seaweedbazaar/halloween-scooby-doo/scooby-booth-main/prompts/base.md

Image 1 is the art style reference. Image 2 is the lettering reference. Image 3 is a photo of a real person, who is the star of this comic: "the hero".

HERO DESCRIPTION (from Image 3 — follow exactly in every panel):
{{HERO_DESCRIPTION}}

{{RETRY_NOTES}}

Create a 4-panel comic strip that looks like a photographed page from a real 1970s Gold Key Scooby-Doo comic book printed on cheap newsprint. Match Image 1's art style and Image 2's lettering exactly. Use them for style only; do not copy their panels or text.

PRINT TEXTURE (most important for the look; match Image 1):
- Colors are printed with visible Ben-Day halftone dots, especially on skin, pink, yellow and blue areas. Not smooth solid fills. Halftone dots on skin keep the skin exactly as light or dark as in Image 3.
- Slight color misregistration: color fills shifted a little off the black linework, leaving small white gaps along edges and color spilling past outlines.
- Inside the panels: a slightly yellowed newsprint look with faint grain, slight ink bleed, and a soft, slightly blurry scanned-page feel. The yellowing never applies to anyone's skin.
- Limited flat 4-color print palette: hot pink, lemon yellow, sky blue, grass green, orange, purple, brown, black. No smooth gradients, no airbrushed or soft shading, no modern cel shading.
- Glowing ghosts, eyes and lights are fine, but keep them in the same flat print colors with halftone dots.
- It must look like a genuine old printed comic, not a modern digital illustration made to look retro.

LINEWORK:
- Hand-inked with a brush: thick-to-thin varying line weight, slightly uneven and wobbly, not uniform digital lines.
- Shadows done with scratchy black hatching and feathering lines, especially in hair, fur and clothing folds, not with shaded color tones.
- Only hair that is actually black or very dark is filled with solid black ink, with a few flat blue or white highlight shapes. Every character keeps their own hair color (blonde, red, brown, gray, etc.); never change anyone's hair color to black.
- Simple 1970s comic proportions like Image 1: realistic adult bodies about 7 heads tall with SMALL heads, simple inked faces, small eyes with NO shine highlights, expressions shown through eyebrows and body language. NOT a Bitmoji, NOT an avatar, NOT a modern webcomic, NOT a caricature app. No big round eyes, no glossy highlights, no smooth vector lines.

LETTERING (must look hand-lettered in a real 1970s comic book; copy Image 2 exactly):
- Hand-lettered with a pen by a comic letterer, not a computer font. Every letter is drawn by hand, so repeated letters are never identical: slight differences in size, slant and stroke thickness.
- SMALL, DENSE TEXT like Image 2: ALL CAPS letters that are small relative to the panel (roughly the height of a character's eye), narrow and condensed (each letter about half as wide as it is tall), packed tightly together with almost no space between letters, normal single spaces between words, and tight line spacing (lines nearly touching). The text forms a compact, dense block.
- The bubble hugs the text block snugly, with only a thin margin of white around it. Never a big bubble with large, airy, widely spaced letters.
- Pen strokes go thick and thin, with slightly rough, soft ink edges that spread a little into the newsprint.
- The crossbar "I" (with little bars at the top and bottom) is used ONLY for the word "I" and in "I'M" or "I'VE". All other I's are a plain single stroke.
- Emphasized words are bolder, heavier and slightly slanted.
- Ellipses are drawn as three well-spaced dots.
- Each line of text is centered in the bubble.
- Speech bubbles are hand-drawn ovals with thin, slightly wobbly black outlines, shaped snugly around the text, with a short, thin, pointed wedge tail.
- AVOID: digital comic fonts, Comic Sans, perfectly even letters, wide letter spacing, thick uniform bubble outlines, rounded-rectangle bubbles.

SOUND EFFECTS (NEVER in bubbles):
- Hand-drawn display letters, like "AAARRRGGH!" in Image 1: letters grow or shrink and tilt along the word, slightly overlapping, with a bouncy, irregular rhythm.
- Filled with a flat print color (hot pink, yellow or orange), outlined with a thick dark outline, and printed with the same halftone dots as the art.
- Placed in the background art behind the characters.

LIKENESS (equally important — these rules decide WHAT the hero looks like; the style rules above decide HOW everything is drawn and printed, including the hero):
- The hero IS the main person in the center of Image 3 (ignore anyone else partly visible at the edges of the photo) and matches the HERO DESCRIPTION exactly. Never invent a different person. Never change their skin tone, ethnicity or age.
- Draw their face and build exactly as they look in Image 3. Do not make them look more masculine or more feminine than they do in the photo, and do not push them toward a stereotypical man or woman.
- The hero is their own person, NOT a member of the Scooby-Doo gang. Never ADD anything from Shaggy's, Fred's, Velma's or Daphne's look that the person doesn't have (for example a goatee, bell-bottoms, an ascot, an orange sweater). If their own hair or features happen to resemble a gang member, draw their own exactly as in Image 3.
- HERO OUTFIT: on top, exactly the clothing visible in Image 3. From the waist down, exactly the "Lower half" given in the HERO DESCRIPTION. The full outfit is identical in every panel.
- The hero's outfit must never resemble any gang member's, and must look clearly different from the gang member they are standing next to. The hero NEVER wears: a skirt or dress (unless shown in Image 3), knee socks, Mary Jane shoes, bell-bottoms, an ascot, a neck scarf, a turtleneck, a headband, Velma's orange sweater or red skirt, Daphne's purple dress, pink tights or green scarf, Fred's white shirt and ascot, or Shaggy's green V-neck and brown pants.
- Hair: exactly as described and as in Image 3, in every panel. Never shorten it, tie it up, pull it back or hide it unless it is worn that way in Image 3. If long hair is pushed back, slicked back or tied, still show its real length (strands falling behind or over the shoulders) and texture; never turn it into short or rounded hair. Keep the exact hair color and lightness, including any gray: light blonde stays pale blonde, never darkened to golden-brown or brown.
- Facial hair: exactly as described. If the person has no facial hair, the hero's chin, jaw and upper lip are completely clean-shaven in EVERY panel: no stubble, no goatee, no chin whiskers.
- Face shape: copy the face shape from Image 3 (round stays round, soft stays soft). Never give the hero a long, narrow face, a prominent chin or droopy eyes they don't have.
- Skin tone: exactly as light or dark as in Image 3. In-between tones stay in-between; never round light or olive skin to tan or brown. One flat skin color, identical in every panel.
- Lighting: colored lights only tint the background and the floor. They never change the color of anyone's skin, hair or clothes.
- Facial features: keep their eye shape, eyelids, nose shape, lips, face shape, jawline and cheekbones exactly as in Image 3.
- Glasses, facial hair, piercings, earrings, jewelry, hats and clothing: exactly as described and as in Image 3, including logos. Do not invent new clothes unless the story says so.
The hero is drawn in the 1970s comic style, but their face may have slightly more detail than the other characters, enough to keep these features accurate.

PANELS: {{LAYOUT}} ALL FOUR panels are fully enclosed by the same thick black hand-ruled border, separated by gutters. Everything outside the panels (the page margins around the edge and the gutters between panels) is clean, flat, pure white #FFFFFF: no yellowing, no paper texture, no grain, no halftone dots, no stains. No borderless or full-bleed panels; no art extends outside its border.

HEADCOUNT (check every panel before drawing it): count the characters the story names for that panel and draw exactly that many people, no more. Show movement only with speed lines and motion marks, never by drawing a character more than once. Every character, including each Scooby-Doo gang member, appears at most ONCE per panel. Never fill extra space with a copy of a character; use background scenery instead.

THE HERO: the person from Image 3, following the HERO DESCRIPTION and LIKENESS rules. Same look in every panel. Appears ONLY ONCE per panel. Whenever the hero is next to another human character, draw them at the same scale and the same distance from the viewer; neither towers over the other.

{{STORY}}

GLOBAL TEXT RULES: Spell all text exactly as written in quotes. No other words anywhere: NO caption boxes, no narration, no time stamps, no signs, no banners, no labels, no titles, no signatures. Logos or text on the hero's own clothing from Image 3 may stay. Nothing flies through the air unless the story says so; no floating heads or extra faces.

FINAL CHECK: The hero is clearly the same person as in Image 3 in all four panels: same skin tone (never darkened by lighting or the paper effect), ethnicity, age, facial features, hair, glasses, facial hair, piercings and clothing. All four panels have black borders. Each character appears once per panel with one head. It looks like a real scanned 1970s newsprint comic page: visible halftone dots (including on skin), misregistered color, yellowed paper, brushy ink with scratchy hatching, flat print colors with no soft glow, and pen-lettered text exactly like Image 2. Not a clean modern digital comic, and not Bitmoji-style characters.
