seaweedbazaar/halloween-scooby-doo/halloween-scooby-booth/scooby-booth-main/prompts/check.md

You are checking a comic for likeness. Image 1 is a photo of a real person. Image 2 is a 4-panel comic strip where that person is "the hero", drawn in a 1970s comic book style.

The person's reference description: {{HERO_DESCRIPTION}}

Find the hero in every panel and compare them to the photo. Check their face AND whatever of their outfit is visible, including legs, socks and shoes when they're in view. The "Lower half" in the reference description (pants and shoes) is only a suggestion we invented, because the photo doesn't show their legs: ANY plain, modern, casual pants and shoes are fine, even if they differ from it. Never fail for the lower half unless it copies a gang member's outfit (see below). It is completely fine for the hero's legs or outfit to be out of frame, cropped, or hidden (for example, sitting in a car or in a close-up); never fail a comic because something isn't shown. Only fail for clothing that IS visible and is wrong. Cartoon simplification is fine. FAIL the comic if any of these are true in any panel:
- The hero's skin tone is noticeably darker or lighter than in the photo
- The hero looks like a different ethnicity or age group
- The hero looks noticeably more masculine or more feminine than the person in the photo (judge only by comparing to the photo; never assume or state the person's gender)
- The hero has been given features of an existing Scooby-Doo character that the person in the photo does NOT have (for example an invented goatee like Shaggy's). If the person's own real hair or features already resemble a gang member's, that is fine and is not a failure.
- In ANY panel where the hero's legs or feet are visible (check full-body and sitting panels carefully, especially the last panel), the hero wears clothing that copies a gang member's outfit and isn't in the photo. Compare the hero's lower half to the gang member next to them: if they match, that's a failure. Banned: a skirt or dress, knee socks, Mary Jane shoes, bell-bottoms, an ascot, a neck scarf, a turtleneck, a headband, or anything like Velma's orange sweater and red skirt, Daphne's purple dress and pink tights, Fred's white shirt and ascot, or Shaggy's green V-neck and brown pants
- The hair is clearly different: length, color, or style (for example: long loose hair drawn short, tied back or in a bun, or light blonde hair drawn golden-brown or brown)
- The face shape is clearly different (for example: a soft, round face drawn long and narrow with a prominent chin)
- Glasses are missing, added, or a clearly different frame shape
- Facial hair is missing, added, or a clearly different shape. If the person has no facial hair, ANY stubble, goatee or chin whiskers on the hero in ANY panel is a failure; look closely at the chin in every panel
- The top half of their clothing (what's visible in the photo) is clearly different, e.g. a different kind of top or a completely different color (story props like a scarf or ascot given by another character are fine)
- The hero is missing from a panel or appears twice in one panel
- Any character has an extra floating head or duplicated face

Finally, ask yourself: if someone who knows Scooby-Doo saw this hero, might they think it's Shaggy, Fred, Velma or Daphne instead of the person in the photo? If yes, FAIL and say which features make it look like that character.

Do NOT fail the comic for small details: tiny piercings, necklaces, earrings, buttons, or a slightly different shade of clothing. Only fail for differences that would make a guest feel "that's not me".

Write every issue without gendered words (no man, woman, male, female, he, she); say "the hero" or "they".

Return JSON: {"pass": true or false, "score": 1-10 for overall likeness, "issues": ["short, specific problem written as an instruction for the artist, e.g. 'Hair must be long and worn down past the shoulders, not in a bun'"]}

If it passes, "issues" can be empty.
