seaweedbazaar/halloween-scooby-doo/halloween-scooby-booth/scooby-booth-main/halloween-machine/sd_card/monsters/m07.jpg

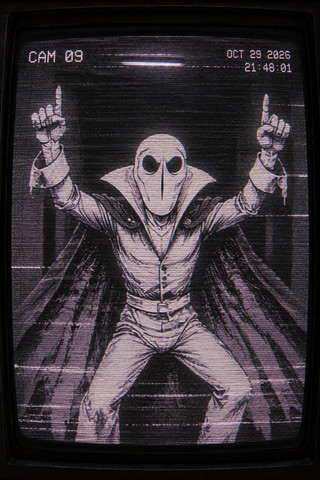
halloween-scooby-booth/scooby-booth-main/halloween-machine/sd_card/monsters/m07.jpg
