seaweedbazaar/halloween-scooby-doo/halloween-scooby-booth/scooby-booth-main/halloween-machine/sd_card/monsters/m09.jpg

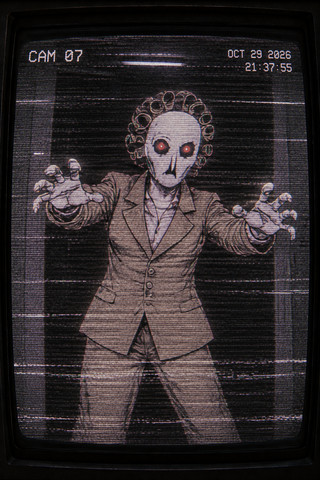
halloween-scooby-booth/scooby-booth-main/halloween-machine/sd_card/monsters/m09.jpg
