seaweedbazaar/halloween-scooby-doo/halloween-scooby-booth/scooby-booth-main/hardware/images/architecture.png

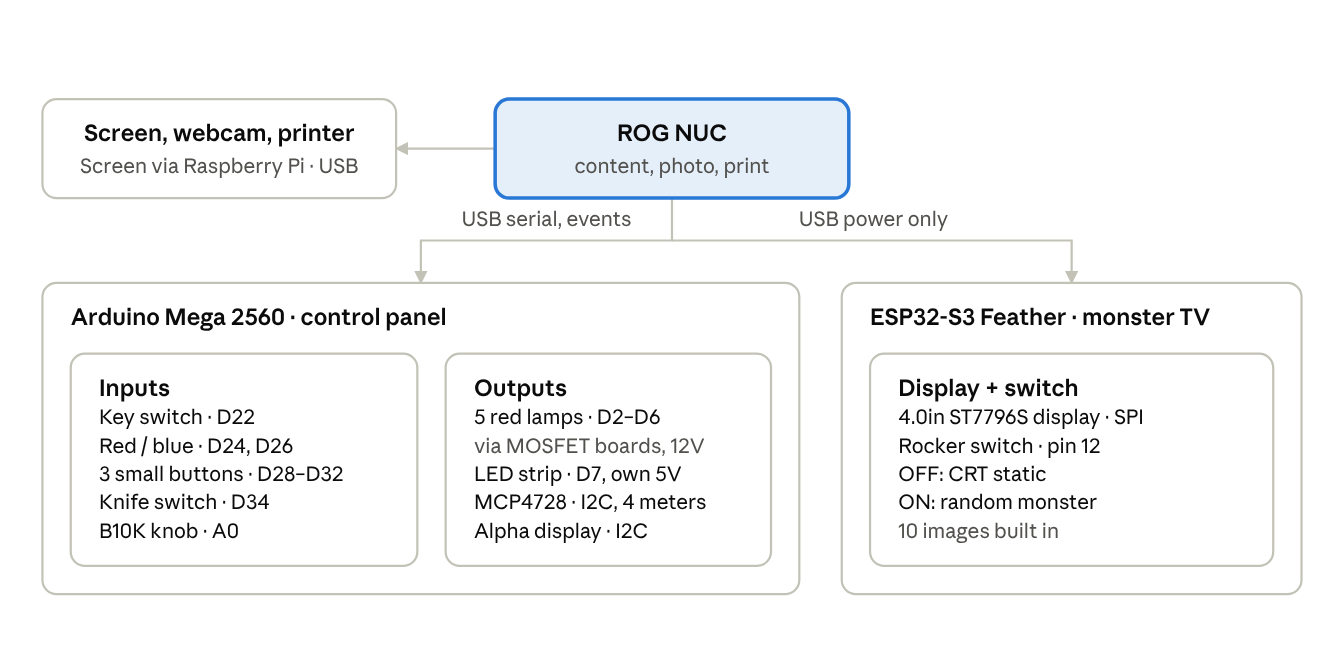
halloween-scooby-booth/scooby-booth-main/hardware/images/architecture.png
