seaweedbazaar/halloween-scooby-doo/halloween-scooby-booth/scooby-booth-main/references/lettering.png

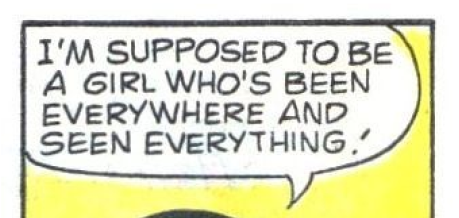
halloween-scooby-booth/scooby-booth-main/references/lettering.png
