seaweedbazaar/halloween-scooby-doo/scooby-booth-main/halloween-machine/sd_card/monsters/m01.jpg

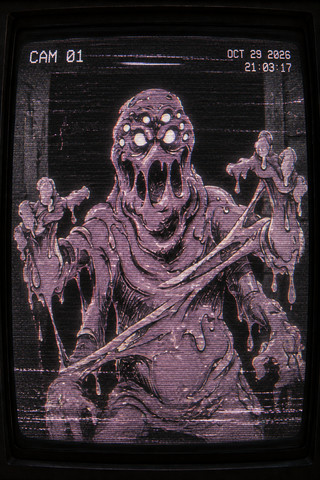
scooby-booth-main/halloween-machine/sd_card/monsters/m01.jpg
