seaweedbazaar/halloween-scooby-doo/scooby-booth-main/halloween-machine/sd_card/monsters/m05.jpg

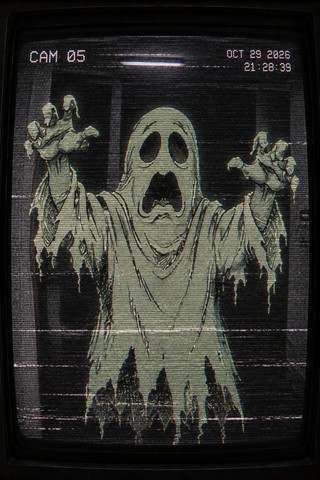
scooby-booth-main/halloween-machine/sd_card/monsters/m05.jpg
