seaweedbazaar/halloween-scooby-doo/scooby-booth-main/references/style.png

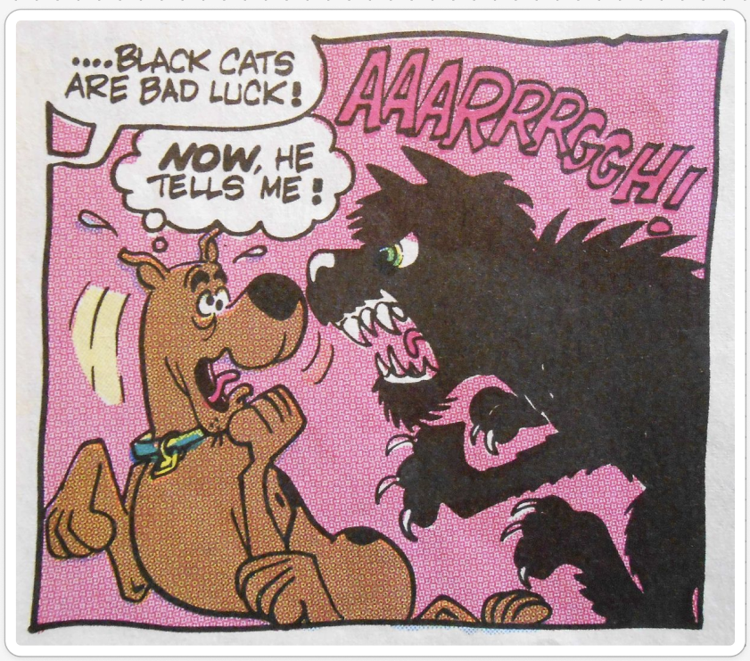
scooby-booth-main/references/style.png
