seaweedbazaar/halloween-scooby-doo/halloween-scooby-booth/scooby-booth-main/hardware/models/scooby-panel-preview.stl

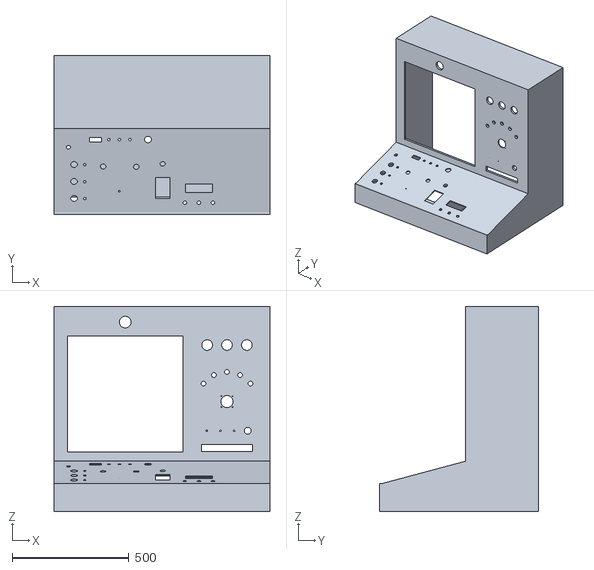
[picture p12: CAD file, 2026-11-02]
halloween-scooby-booth/scooby-booth-main/hardware/models/scooby-panel-preview.stl
924.0 x 681.4 x 877.8
