seaweedbazaar/halloween-scooby-doo/halloween-scooby-booth/scooby-booth-main/hardware/models/lightbox-preview.stl

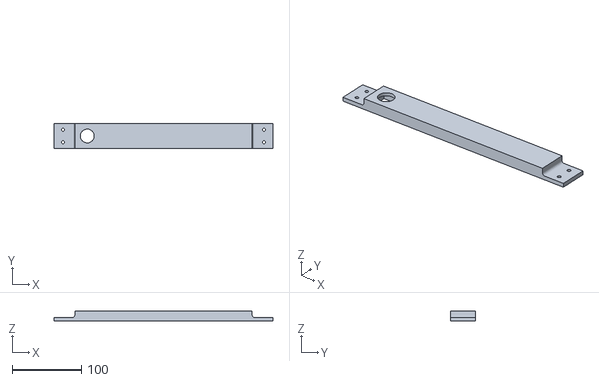
[picture p13: CAD file, 2026-11-02]
halloween-scooby-booth/scooby-booth-main/hardware/models/lightbox-preview.stl
316.0 x 36.0 x 14.0
