seaweedbazaar/halloween-scooby-doo/(list of files, cad)

Other CAD files:
halloween-scooby-booth/scooby-booth-main/hardware/models/scooby-panel.f3d
scooby-booth-main/hardware/models/lightbox.f3d
