seaweedbazaar/halloween-scooby-doo/halloween-scooby-booth/hardware-testing/sd_card/monsters/m02.jpg

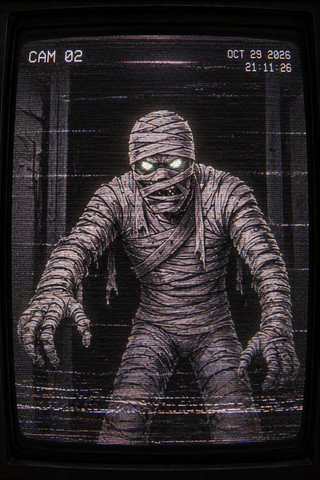
halloween-scooby-booth/hardware-testing/sd_card/monsters/m02.jpg
