seaweedbazaar/halloween-scooby-doo/halloween-scooby-booth/hardware-testing/sd_card/monsters/m08.jpg

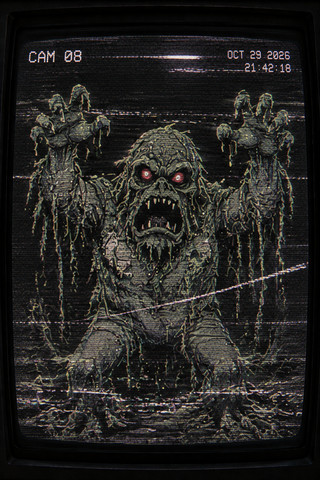
halloween-scooby-booth/hardware-testing/sd_card/monsters/m08.jpg
