seaweedbazaar/halloween-scooby-doo/hardware-testing/sd_card/monsters/m06.jpg

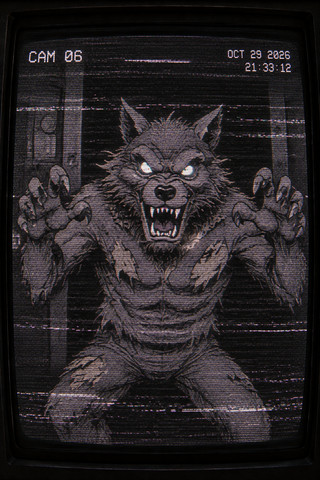
hardware-testing/sd_card/monsters/m06.jpg
