seaweedbazaar/halloween-scooby-doo/hardware-testing/sd_card/monsters/m10.jpg

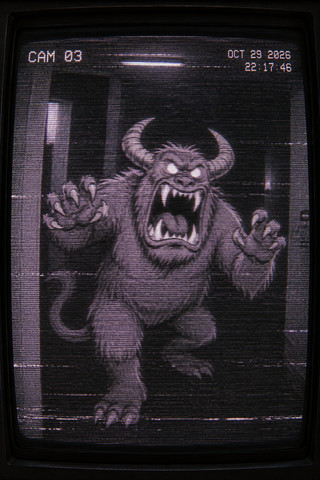
hardware-testing/sd_card/monsters/m10.jpg
