seaweedbazaar/halloween-scooby-doo/scooby-booth-main/references/card-back.png

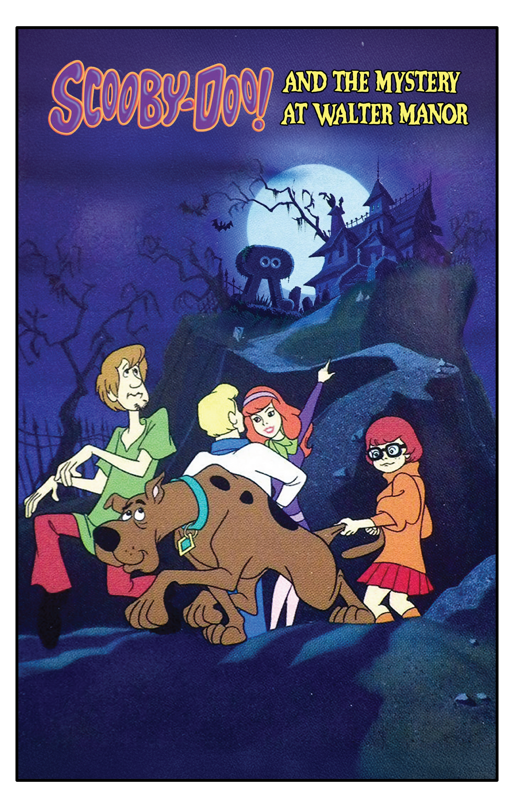
scooby-booth-main/references/card-back.png
